roboime/BattleBot-HardwareBoards/README.md

# BattleBot-HardwareBoards
Este é o repositório que guarda os projetos das placas eletrônicas usadas nos robôs de combate da RoboIME. É necessário o Altium Designer 16+ para a abertura dos projetos.
