roboime/BattleBot-HardwareBoards/Carrier_Board/Cb_2018.2(camara)/CBpcisionamento.step

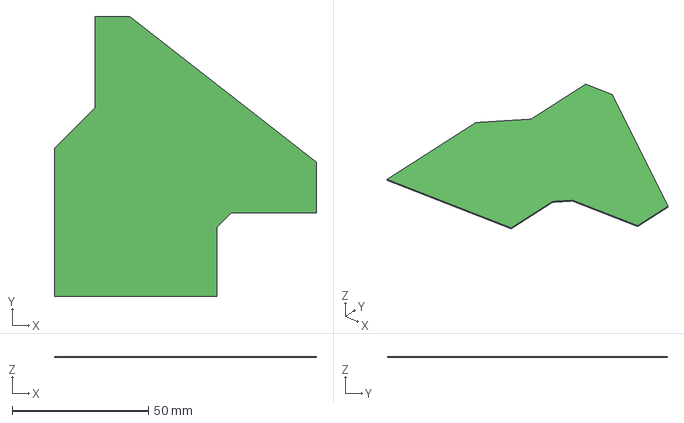
[picture p3: CAD file, 2019-02-14]
Carrier_Board/Cb_2018.2(camara)/CBpcisionamento.step
96.1 x 102.9 x 0.411 mm
