roboime/BattleBot-HardwareBoards/Carrier_Board/Cb_2019(ATUAL)/Componentes/LIB_C1608X5R1V335K080AC/C1608X5R1V335K080AC/3D/C1608X5R1V335K080AC.stp

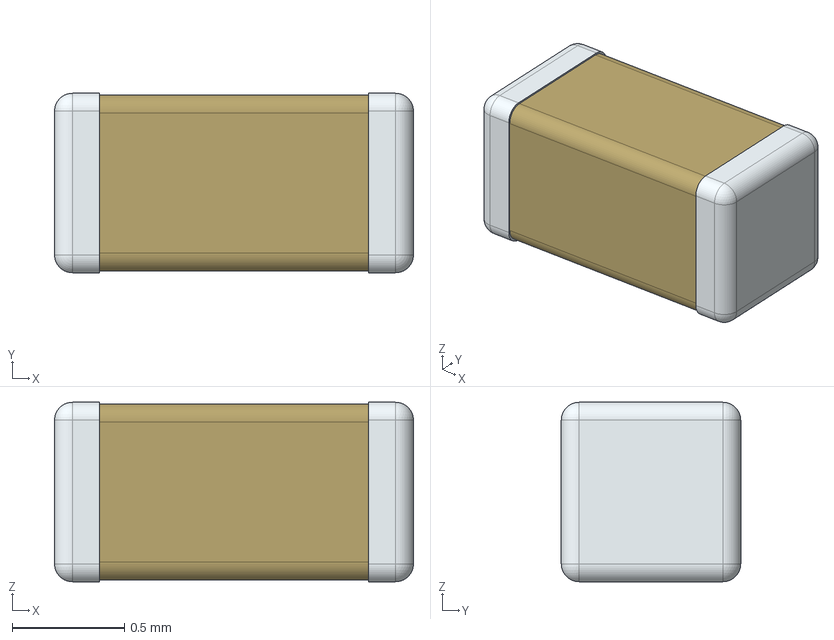
[picture p4: CAD file, 2019-05-28]
Carrier_Board/Cb_2019(ATUAL)/Componentes/LIB_C1608X5R1V335K080AC/C1608X5R1V335K080AC/3D/C1608X5R1V335K080AC.stp
1.60 x 0.8 x 0.8 mm
