roboime/BattleBot-HardwareBoards/Carrier_Board/Cb_2019(ATUAL)/Componentes/LIB_SPM7054VT-101M-D/SPM7054VT-101M-D/3D/SPM7054VT-101M-D.stp

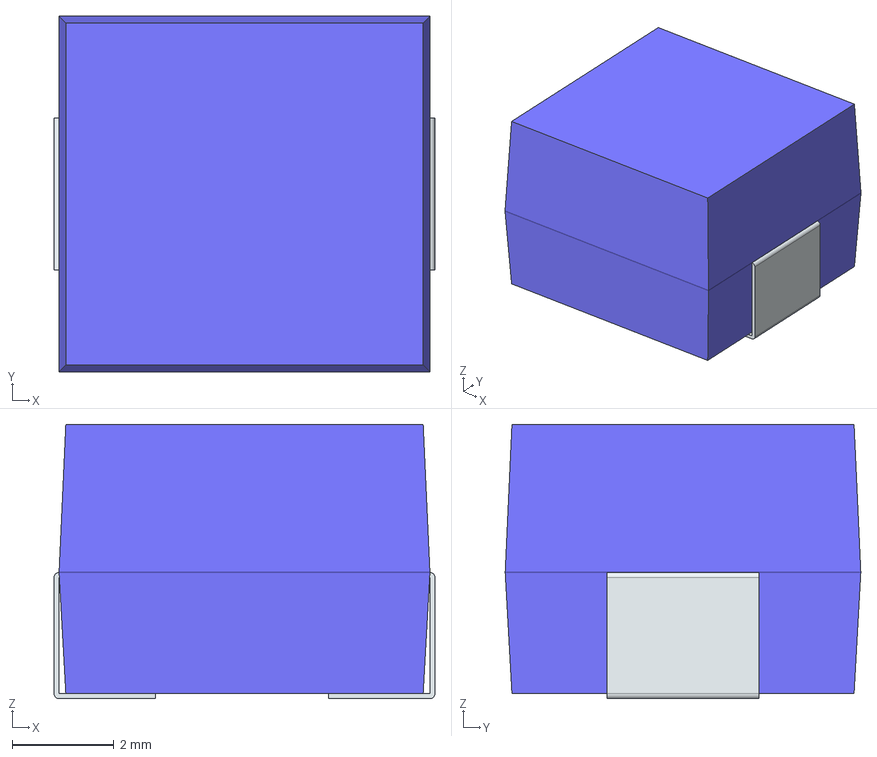
[picture p5: CAD file, 2019-05-28]
Carrier_Board/Cb_2019(ATUAL)/Componentes/LIB_SPM7054VT-101M-D/SPM7054VT-101M-D/3D/SPM7054VT-101M-D.stp
7.50 x 7.00 x 5.40 mm
FilletPin1
FilletPin2
