roboime/BattleBot-HardwareBoards/(list of files, cad)

Other CAD files:
Carrier_Board/Cb_2019(ATUAL)/Componentes/LIB_C1608X5R1V335K080AC/C1608X5R1V335K080AC/3D/C1608X5R1V335K080AC.stl
Carrier_Board/Cb_2019(ATUAL)/Componentes/LIB_C1608X5R1V335K080AC/C1608X5R1V335K080AC/Allegro/capc1608x80n.psm
Carrier_Board/Cb_2019(ATUAL)/Componentes/LIB_C1608X5R1V335K080AC/C1608X5R1V335K080AC/DEHDL/C1608X5R1V335K080AC/chips/chips.prt
Carrier_Board/Cb_2019(ATUAL)/Componentes/LIB_SPM7054VT-101M-D/SPM7054VT-101M-D/3D/SPM7054VT-101M-D.stl
