roboime/BattleBot-HardwareBoards/Morpheus/Driver MorpheusV6.pdf

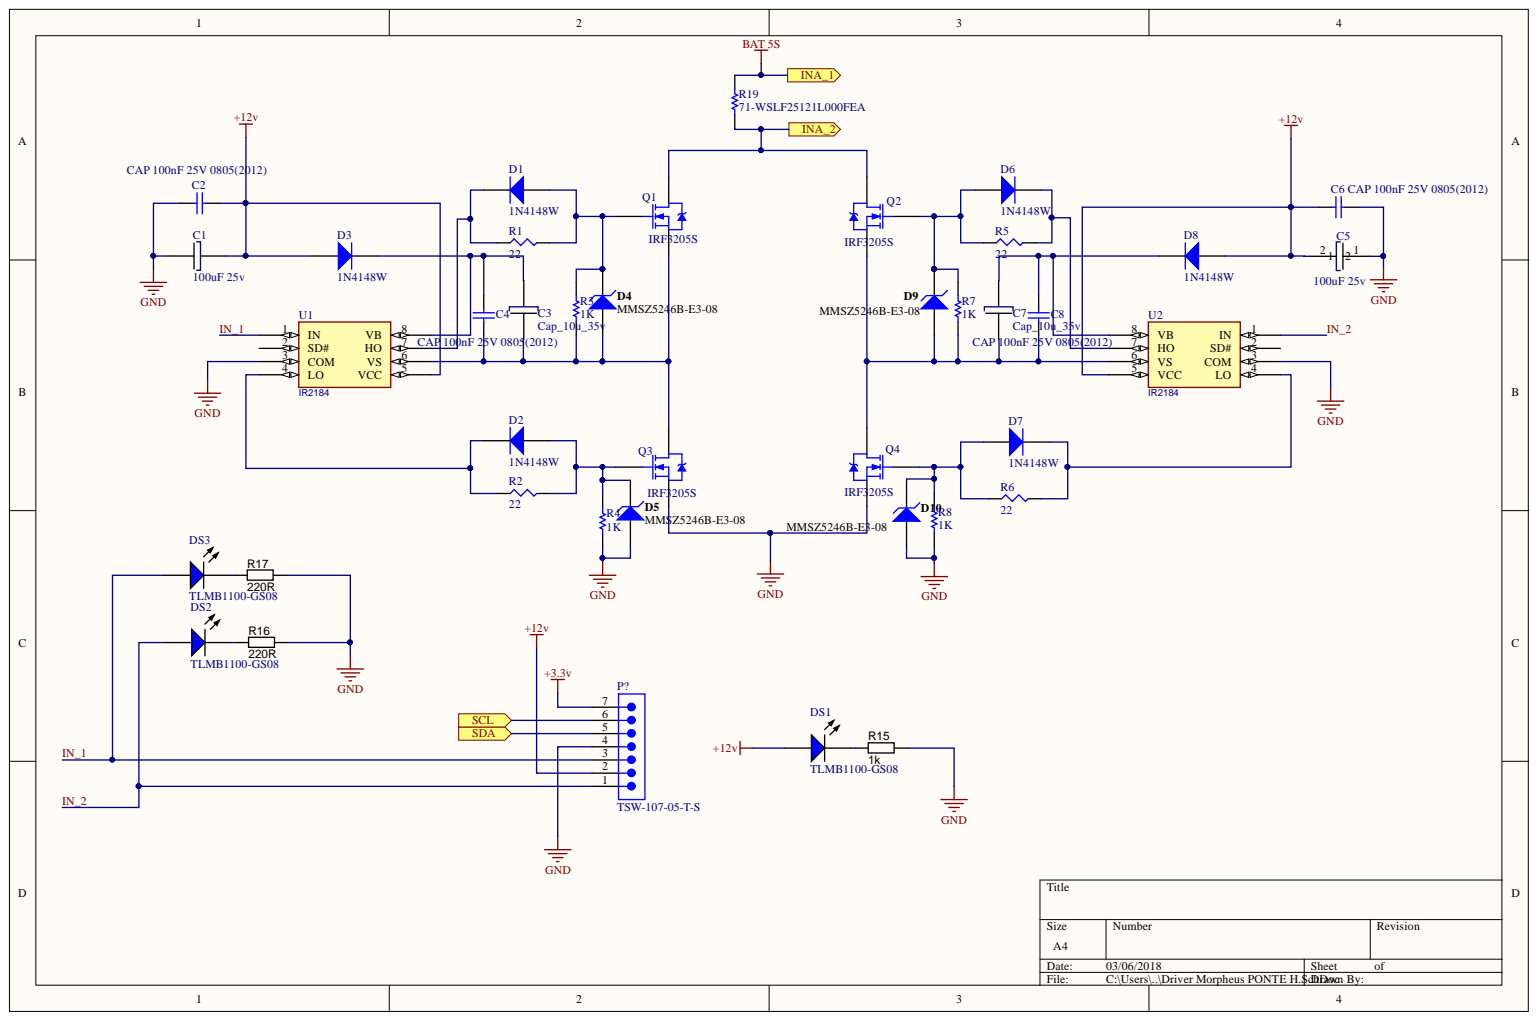
[picture p12: page 1]

IN_1
IN_2 | | 2

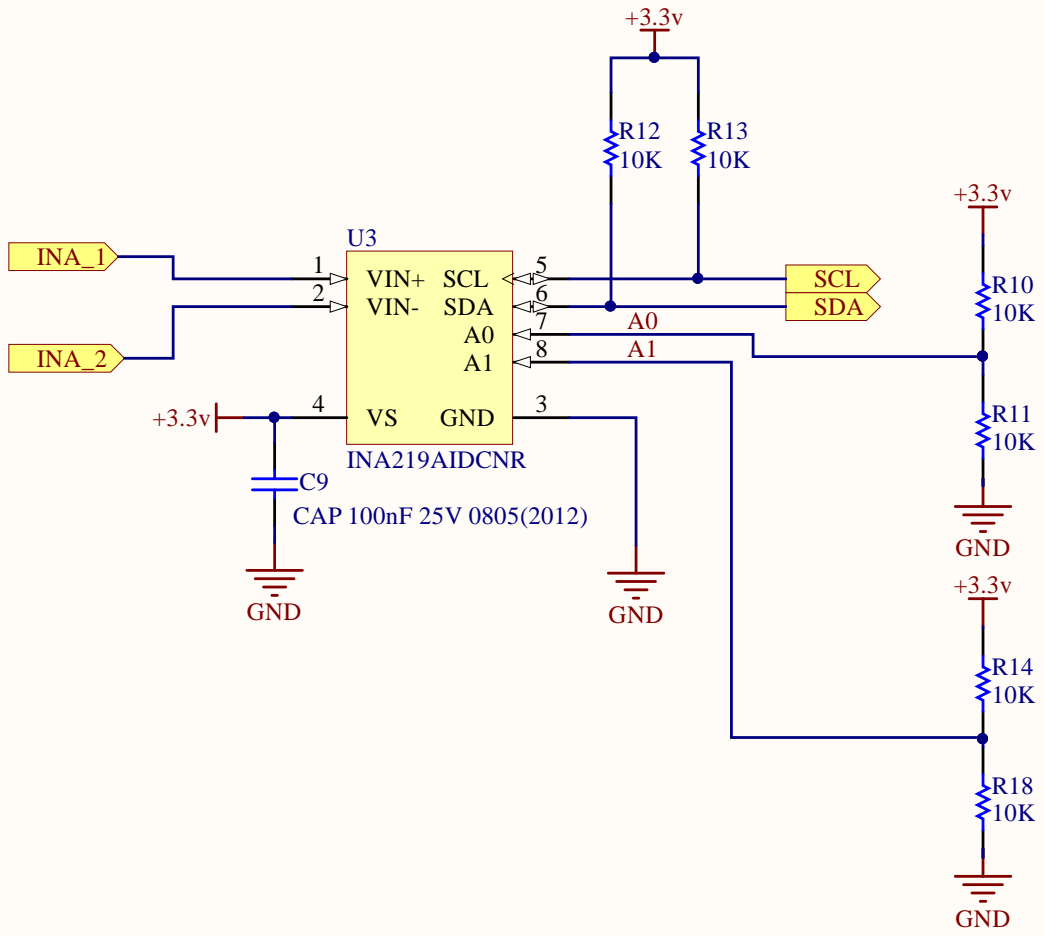
[picture p13: page 2]

NSOR CODRRE rawNn By TE.Sch :
