roboime/BattleBot-HardwareBoards/(list of files, drawings)

Other design files:
Carrier_Board/CB_2018.1/Carrier_Board.PcbDoc
Carrier_Board/CB_2018.1/Carrier_Board.PrjPcb
Carrier_Board/CB_2018.1/Carrier_Board.SchDoc
Carrier_Board/CB_2018.1/ESC.SchDoc
Carrier_Board/CB_2018.1/ESP8266.SchDoc
Carrier_Board/CB_2018.1/INA169.SchDoc
Carrier_Board/CB_2018.1/INA219AID.SchDoc
Carrier_Board/CB_2018.1/Medidor bateria.SchDoc
Carrier_Board/CB_2018.1/Morpheus_conector.SchDoc
Carrier_Board/CB_2018.1/MPU 9250.SchDoc
Carrier_Board/CB_2018.1/Recepitor.SchDoc
Carrier_Board/CB_2018.1/Step Down.schdoc
Carrier_Board/CB_2018.1/Termistor.SchDoc
Carrier_Board/Cb_2018.2(camara)/CarrierBoard.PrjPcb
Carrier_Board/Cb_2018.2(camara)/CarrierBoard.SchDoc
Carrier_Board/Cb_2018.2(camara)/CBpcisionamento.PcbDoc
Carrier_Board/Cb_2018.2(camara)/CircuitoControle.SchDoc
Carrier_Board/Cb_2018.2(camara)/Morpheus.SchDoc
Carrier_Board/Cb_2018.2(camara)/Perifericos.SchDoc
Carrier_Board/Cb_2018.2(camara)/Regulador5V.SchDoc
Carrier_Board/Cb_2019(ATUAL)/53398-0771.PcbLib
Carrier_Board/Cb_2019(ATUAL)/53398-0771.SchLib
Carrier_Board/Cb_2019(ATUAL)/CarrierBoard.PcbDoc
Carrier_Board/Cb_2019(ATUAL)/CarrierBoard.PrjPcb
Carrier_Board/Cb_2019(ATUAL)/CarrierBoard.SchDoc
Carrier_Board/Cb_2019(ATUAL)/CBAT54C TR.SchLib
Carrier_Board/Cb_2019(ATUAL)/CBpcisionamento.PcbDoc
Carrier_Board/Cb_2019(ATUAL)/CircuitoControle.SchDoc
Carrier_Board/Cb_2019(ATUAL)/Morpheus.SchDoc
Carrier_Board/Cb_2019(ATUAL)/Perifericos.SchDoc
Carrier_Board/Cb_2019(ATUAL)/Regulador5V.SchDoc
Carrier_Board/Cb_2019(ATUAL)/SamacSys.PcbLib
Carrier_Board/Cb_2019(ATUAL)/SamacSys.SchLib
Morpheus/Driver Morpheus Melhorado/Driver Morpheus PONTE H.PcbDoc
Morpheus/Driver Morpheus Melhorado/Driver Morpheus PONTE H.PrjPcb
Morpheus/Driver Morpheus Melhorado/Driver Morpheus PONTE H.SchDoc
Morpheus/Driver Morpheus Melhorado/Driver Morpheus SENSOR CORRENTE.SchDoc
Morpheus/Morpheus2017/Driver Morpheus CENTRAL.PcbDoc
Morpheus/Morpheus2017/Driver Morpheus CENTRAL.PrjPcb
Morpheus/Morpheus2017/Driver Morpheus CENTRAL.SchDoc
Morpheus/Morpheus2017/Driver Morpheus PONTE H.PcbDoc
Morpheus/Morpheus2017/Driver Morpheus PONTE H.PrjPcb
Morpheus/Morpheus2017/Driver Morpheus PONTE H.SchDoc
Morpheus/Morpheus v7.0(Atual)/Driver Morpheus v7.0.PcbDoc
Morpheus/Morpheus v7.0(Atual)/Driver Morpheus V7.0.PrjPcb
Morpheus/Morpheus v7.0(Atual)/Driver Morpheus V7.0.SchDoc
Morpheus/Morpheus v7.0(Atual)/INA169.SchDoc
Morpheus/Morpheus v7.0(Atual)/PCB Library Documents/53398-0771.PcbLib
Morpheus/Morpheus v7.0(Atual)/PCB Library Documents/LibSanhaço2017.SchLib
Morpheus/Morpheus v7.0(Atual)/PCB Library Documents/LibSanhaço2017_2.SchLib
Morpheus/Morpheus v7.0(Atual)/PCB Library Documents/MissingComponents.PcbLib
Morpheus/Morpheus v7.0(Atual)/PCB Library Documents/PcbLib1.PcbLib
Morpheus/Morpheus v7.0(Atual)/Schematic Library Documents/LibSanhaço2017.SchLib
Morpheus/Morpheus v7.0(Atual)/Schematic Library Documents/LibSanhaço2017_2.SchLib
Morpheus/MorpheusV6.2/Driver Morpheus PONTE H.PcbDoc
Morpheus/MorpheusV6.2/Driver Morpheus PONTE H.PrjPcb
Morpheus/MorpheusV6.2/Driver Morpheus PONTE H.SchDoc
Morpheus/MorpheusV6.2/Driver Morpheus SENSOR CORRENTE.SchDoc
Morpheus/MorpheusV6.2/LIB MorpheusV6/LibSanhaço2017.SchLib
Morpheus/MorpheusV6.2/LIB MorpheusV6/LibSanhaço2017_2.SchLib
Morpheus/MorpheusV6.2/LIB MorpheusV6/MissingComponents.PcbLib
Morpheus/MorpheusV6.2/LibSanhaço2017.SchLib
Morpheus/MorpheusV6.2/LibSanhaço2017_2.SchLib
Morpheus/MorpheusV6.2/MissingComponents.PcbLib
Morpheus/MorpheusV6.2/PCB_Project1.PrjPCB
Morpheus/MorpheusV6.2/PcbLib1.PcbLib
