roboime/BattleBot-HardwareBoards/(commit log)

2017-05-25 Adiciona o projeto central
    [Sanhaço2017-centralSMD.pdsprj]
2017-06-15 Esquemático completo para análise e validação.
2017-06-15 Converter para o Altium
    [Driver Morpheu v4.0 CENTRAL.SchDoc, Driver Morpheu v4.0 PONTE H.SchDoc, Driver Morpheu v4.0 SMD.PrjPcb, Driver Morpheu v4.0.PcbDoc, Sanhaço2017-centralSMD.pdsprj]
2017-06-15 Novo upload da placa
    [Driver Morpheu v4.0 CENTRAL.SchDoc, Driver Morpheu v4.0 PONTE H.SchDoc, Driver Morpheu v4.0 SENSOR CORRENTE.SchDoc, Driver Morpheu v4.0 SMD.PrjPcb]
2017-06-15 O circuito foi reorganizado.
2017-06-17 Modificações para hierarquisação do projeto para permirtir colocar múltiplas instâncias de esquemáticos.
    [Driver Morpheu v4.0 CENTRAL.SchDoc, Driver Morpheu v4.0 PONTE H.SchDoc, Driver Morpheu v4.0 SENSOR CORRENTE.SchDoc, Driver Morpheu v4.0 SMD.PrjPcb, Driver Morpheu v4.0.PcbDoc, MORPHEU.SchDoc]
2017-06-18 Layout da placa atualizado.
    [Driver Morpheu v4.0 CENTRAL.SchDoc, Driver Morpheu v4.0 PONTE H.SchDoc, Driver Morpheu v4.0 SENSOR CORRENTE.SchDoc, Driver Morpheu v4.0 SMD.PrjPcb, Driver Morpheu v4.0.PcbDoc, LibSanhaço2017.SchLib, LibSanhaço2017_2.SchLib, PcbLib1.PcbLib]
2017-06-24 Placa Finalizada, aguardando validação.
    [Driver Morpheus v4.0 CENTRAL.SchDoc, Driver Morpheus v4.0 PONTE H.SchDoc, Driver Morpheus v4.0 SENSOR CORRENTE.SchDoc, Driver Morpheus v4.0 SMD.PrjPcb, Driver Morpheus v4.0.PcbDoc]
2017-06-27 Fiz uma pequena modificação na placa, está pronta.
    [Driver Morpheus v4.0.PcbDoc]
2017-06-28 Correções na placa
    [Driver Morpheu v4.0 SMD.PrjPcb, Driver Morpheu v4.0.PcbDoc, Driver Morpheus v4.0 SMD.PrjPcb, Driver Morpheus v4.0.PcbDoc]
2017-06-28 Mudança dos capacitores na placa
    [Driver Morpheus v4.0 SMD.PrjPcb, Driver Morpheus v4.0.PcbDoc, MissingComponents.PcbLib]
2017-06-29 Modificações finais na placa
    [Driver Morpheus v4.0 SMD.PrjPcb, Driver Morpheus v4.0.PcbDoc, MissingComponents.PcbLib]
2017-06-29 Revert "Fiz uma pequena modificação na placa, está pronta."
    This reverts commit 2449cb5641a130d8d21dd946fee8d5d02cca53a6.
    [Driver Morpheus v4.0.PcbDoc]
2017-07-03 Revisão Serrenho.
    [Driver Morpheus v5.2 CENTRAL.PrjPcb, Driver Morpheus v5.2 CENTRAL.SchDoc, LibSanhaço2017.SchLib, LibSanhaço2017_2.SchLib, MissingComponents.PcbLib]
2017-07-04 Organização dos arquivos da placa e ajuste dos conectores concluidos
    [Driver Morpheu v4.0 CENTRAL.SchDoc, Driver Morpheu v4.0 PONTE H.SchDoc, Driver Morpheu v4.0 SENSOR CORRENTE.SchDoc, Driver Morpheu v4.0 SMD.PrjPcb, Driver Morpheu v4.0.PcbDoc, Driver Morpheus CENTRAL.PrjPcb, Driver Morpheus CENTRAL.SchDoc, Driver Morpheus PONTE H.PcbDoc]
2017-07-04 Layout Melhorado
    [Driver Morpheus PONTE H.PcbDoc, Driver Morpheus PONTE H.PrjPcb, Driver Morpheus PONTE H.SchDoc, Driver Morpheus SENSOR CORRENTE.SchDoc]
2017-07-04 Placa central
    [Driver Morpheus CENTRAL.PcbDoc, Driver Morpheus CENTRAL.PrjPcb, Driver Morpheus CENTRAL.SchDoc]
2018-04-07 MorpheusV6 atualizada
    Ultima versão compactada da placa de versão anterior (MorpheusV5)
    [Driver Morpheus PONTE H.PcbDoc, Driver Morpheus PONTE H.PrjPcb, Driver Morpheus PONTE H.SchDoc, LibSanhaço2017.SchLib, LibSanhaço2017_2.SchLib, MissingComponents.PcbLib]
2018-04-30 todos os resistores selecionados
2018-06-03 Versão atualizada v6.2
    Atualizei o que foi definido para o tamanho da placa e adicionei um conector padrão para a placa, o que pode ser mudado na construção.
    Fiz também o design no layout com um INA em cada placa, de forma compacta.
    [Driver Morpheus PONTE H.PcbDoc, Driver Morpheus PONTE H.PrjPcb, Driver Morpheus PONTE H.SchDoc, Driver Morpheus SENSOR CORRENTE.SchDoc, LibSanhaço2017.SchLib, LibSanhaço2017_2.SchLib, MissingComponents.PcbLib, PCB_Project1.PrjPCB]
2018-06-03 Correção R19
    [Driver Morpheus PONTE H.SchDoc]
2018-06-18 Atualização
    Atualizada a Morpheus e o esquemático referente ao ESC, a fim de fazer controle de liga/desliga e reset através do software.
    [Driver Morpheus PONTE H.SchDoc, ESC.SchDoc]
2018-06-20 Atualização Versão Barramento Pino
    Driver atualizado, com INA adicionado e entrada de energia no mesmo lado, com definido na última reunião. Foram trocados os resistores de 1k por 10k, pois tais resistores apresentaram aquecimento leve na MorpheusV5.
    [Driver Morpheus PONTE H.PcbDoc, Driver Morpheus PONTE H.SchDoc]
2018-06-20 Atualização
    Resistores dos leds nas entradas dos drivers atualizados para melhor visualizar o brilho na tensão de ports 3.3v vindo da BluePill
    [Driver Morpheus PONTE H.SchDoc]
2018-06-21 Atualização
    Versão atualizada com conector molex.
    [53398-0771.PcbLib, 53398-0771.SchLib, Driver Morpheus PONTE H.PcbDoc]
2018-06-22 Atualização conector
    [Driver Morpheus PONTE H.PcbDoc]
2018-06-23 Atualização
    Aumentamos a quantidade de vias para reforçar o plano de terra, bem como expusemos vias que estavam por baixo de componentes
    [Driver Morpheus PONTE H.PcbDoc]
2018-06-27 Atualização dos Resistores dos Leds
    [Driver Morpheus PONTE H.SchDoc]
2018-06-28 Atualização de espec de resistores
    [Driver Morpheus PONTE H.SchDoc, Driver Morpheus SENSOR CORRENTE.SchDoc]
2018-06-28 Atualização dos Diodos Zener para 18v
    [Driver Morpheus PONTE H.PcbDoc, Driver Morpheus PONTE H.SchDoc]
2018-06-28 Mouser Part nas descriptions
    [Driver Morpheus PONTE H.SchDoc, Driver Morpheus SENSOR CORRENTE.SchDoc]
2018-06-29 Atualização
    Adicionado led para indicar alimentação 5s e filtro passa baixas no INA.
    [Driver Morpheus PONTE H.PcbDoc, Driver Morpheus PONTE H.SchDoc, Driver Morpheus SENSOR CORRENTE.SchDoc]
2018-06-30 Atualização
    Foi substituido o INA anterior pelo INA169, analógico, para possibilitar melhor precisão. Foram postos filtros na entrada e na saída para evitar os ruídos do chaveamento.
    [Driver Morpheus PONTE H.PcbDoc, Driver Morpheus PONTE H.SchDoc, Driver Morpheus SENSOR CORRENTE.SchDoc, INA169.PCBLIB, INA169.SCHLIB, INA169.SchDoc, SOT23-5.PcbLib]
2018-06-30 Adicionado Plano de Terra
    [Driver Morpheus PONTE H.PcbDoc]
2018-07-01 CONECTORES 52746-1633
    [CarrierBoard.SchDoc, CircuitoControle.SchDoc]
2019-02-14 Organização arquivos CB
    organização para as atividades de 2019
    [CBpcisionamento.PcbDoc, CBpcisionamento.step, CarrierBoard.PrjPcb, CarrierBoard.SchDoc, Carrier_Board.PcbDoc, Carrier_Board.PrjPcb, Carrier_Board.SchDoc, CircuitoControle.SchDoc]
2019-02-14 apagando arguivos repetitos
    [ESC.SchDoc, LibSanhaço2017.SchLib, LibSanhaço2017_2.SchLib, MissingComponents.PcbLib]
2019-02-14 apagando arguivos repetido
    [CarrierBoard.SchDoc]
2019-02-14 Organização arguivos morpheus
    [Driver Morpheus CENTRAL.PcbDoc, Driver Morpheus CENTRAL.PrjPcb, Driver Morpheus CENTRAL.SchDoc, Driver Morpheus PONTE H.PcbDoc, Driver Morpheus PONTE H.PrjPcb, Driver Morpheus PONTE H.SchDoc, Driver Morpheus SENSOR CORRENTE.SchDoc, LibSanhaço2017.SchLib]
2019-02-14 organização lib de componentes
    [INA169.SchDoc]
2019-03-24 Driver 2019 desenhado de forma a atender as demandas definidas na última reunião
    O novo layout da placa conta com mais possibilidades de se acoplar o driver na CB, contém um medidor de corrente utilizando INA169 e 4 leds de debug.
    [53398-0771.PcbLib, Driver Morpheus V7.0.PrjPcb, Driver Morpheus V7.0.SchDoc, Driver Morpheus v7.0.PcbDoc, INA169.SchDoc, LibSanhaço2017.SchLib, LibSanhaço2017_2.SchLib, MissingComponents.PcbLib]
2019-04-01 Revisão CB
    Revisado interface com amorpheus e circuito de contole.
    [53398-0771.PcbLib, 53398-0771.SchLib, CBpcisionamento.PcbDoc, CBpcisionamento.step, CarrierBoard.PrjPcb, CarrierBoard.SchDoc, Carrier_Board.PcbDoc, Carrier_Board.PrjPcb]
2019-04-02 Inversão da pinagem dos conectores
    Inversão da pinagem dos conectores da interface morpheus para adequar ao tipo de flat cable
    [CarrierBoard.PrjPcb, Morpheus.SchDoc]
2019-05-21 TROCA C14 PARA EEE-FK1H221P
    [Regulador5V.SchDoc]
2019-05-22 trocar de componentes para os do partsbox.io
    [CarrierBoard.PcbDoc, CarrierBoard.SchDoc, CircuitoControle.SchDoc, Morpheus.SchDoc, Perifericos.SchDoc, Regulador5V.SchDoc]
2019-05-28 Conector trocado
    Foi trocado conector de 16 por um de 8 pinos molex, agora com pitch maior (1mm), o qual a Imbel possui. Também foi retirado o segundo conector dado que este se tornou desnecessário para o curso do projeto.
    [Driver Morpheus V7.0.PrjPcb, Driver Morpheus V7.0.SchDoc, Driver Morpheus v7.0.PcbDoc]
2019-07-25 Ajustes nas vias troca de componentes
    As vias foram ajustadas e definidas com tent de vias. Além disso, todos os componentes 0402 foram substituídos por 0603, para facilitar a feitura da placa.
    [Driver Morpheus V7.0.PrjPcb, Driver Morpheus V7.0.SchDoc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]
2019-08-26 Connector added
    Adicionado barramento de pinos para solda fixa de cablagem.
    [Driver Morpheus V7.0.PrjPcb, Driver Morpheus V7.0.SchDoc, Driver Morpheus v7.0.PcbDoc]
2019-09-09 Capacitores Tantalo errados
    Footprint estava com polaridade invertida. O problema foi consertado.
    [Driver Morpheus V7.0.SchDoc, Driver Morpheus v7.0.PcbDoc]
